PaulBichl/VibePCB-LA/boards/la-ecp5/hardware/la-ecp5-bottom.png

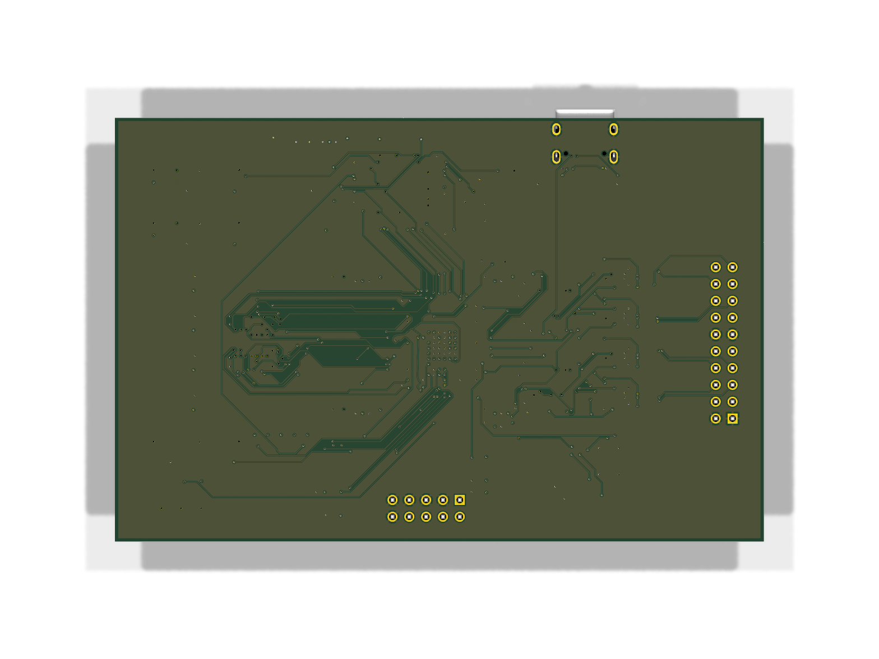
boards/la-ecp5/hardware/la-ecp5-bottom.png
