PaulBichl/VibePCB-LA/boards/la-ecp5/hardware/la-ecp5-bom.csv

Qty | Designator | Value | Footprint | MPN | LCSC Part #
24 | C1,C2,C3,C4,C6,C7,C8,C9,C10,C11,C13,C14,C15,C16,C17,C20,C21,C22,C23,C25,C32,C35,C36,C41 | 100nF | tscircuit:capacitor_cap0402 |  | C1525
6 | C5,C12,C40,C60,C70,C90 | 10uF | tscircuit:capacitor_cap0603 |  | C19702
2 | C18,C19 | 18pF | tscircuit:capacitor_cap0402 |  | C1549
1 | C24 | 4.7uF | tscircuit:capacitor_cap0603 |  | C19666
4 | C30,C31,C33,C34 | 1uF | tscircuit:capacitor_cap0402 |  | C52923
3 | C61,C71,C91 | 22uF | tscircuit:capacitor_cap0805 |  | C45783
4 | D1,D2,D3,D4 | SRV05-4 | tscircuit:SRV05-4 | SRV05-4 | C2836319
3 | D20,D21,D22 | KT-0603G | tscircuit:KT-0603G | KT-0603G | C12624
1 | J1 | pin_header_pinrow20_p2_54_nopinlabels_rows2 | tscircuit:pin_header_pinrow20_p2_54_nopinlabels_rows2
1 | J2 | TYPE-C-31-M-12 | tscircuit:TYPE-C-31-M-12 | TYPE-C-31-M-12 | C165948
1 | J5 | pin_header_pinrow10_p2_54_rows2 | tscircuit:pin_header_pinrow10_p2_54_rows2
3 | L1,L2,L3 | 2.2µH | tscircuit:inductor_0805 |  | C63167
2 | R1,R2 | 5.1kΩ | tscircuit:resistor_res0402 |  | C25905
2 | R3,R71 | 12kΩ | tscircuit:resistor_res0402 |  | C25752
13 | R4,R6,R7,R8,R9,R10,R50,R51,R54,R55,R72,R91,R93 | 10kΩ | tscircuit:resistor_res0402 |  | C25744
1 | R5 | 2.2kΩ | tscircuit:resistor_res0402 |  | C25879
2 | R52,R56 | 20kΩ | tscircuit:resistor_res0402 |  | C25765
2 | R53,R57 | 10Ω | tscircuit:resistor_res0402 |  | C25077
2 | R61,R92 | 22kΩ | tscircuit:resistor_res0402 |  | C25768
1 | R62 | 100kΩ | tscircuit:resistor_res0402 |  | C25741
3 | R80,R81,R82 | 330Ω | tscircuit:resistor_res0402 |  | C25104
4 | RN1,RN2,RN3,RN4 | 4D02WGJ0102TCE | tscircuit:4D02WGJ0102TCE | 4D02WGJ0102TCE | C25726
4 | RN5,RN6,RN7,RN8 | RTA02-4D105JTH | tscircuit:RTA02-4D105JTH | RTA02-4D105JTH | C458532
1 | U1 | LFE5U-25F-7BG256I | tscircuit:LFE5U-25F-7BG256I | LFE5U-25F-7BG256I | C1550762
1 | U2 | IS42S16160J-7BLI | tscircuit:IS42S16160J-7BLI | IS42S16160J-7BLI | C1348766
1 | U3 | FT2232HL-REEL | tscircuit:FT2232HL-REEL | FT2232HL-REEL | C27882
1 | U4 | USBLC6-2SC6 | tscircuit:USBLC6-2SC6 | USBLC6-2SC6 | C7519
1 | U5 | 93LC56BT-I/OT | tscircuit:93LC56BT-I_OT | 93LC56BT-I/OT | C190271
2 | U6,U7 | SN74LVC8T245PWR | tscircuit:SN74LVC8T245PWR | SN74LVC8T245PWR | C27643
1 | U8 | TLV9062IDR | tscircuit:TLV9062IDR | TLV9062IDR | C398355
1 | U9 | W25Q128JVSIQ | tscircuit:W25Q128JVSIQ | W25Q128JVSIQ | C97521
3 | U10,U11,U12 | TLV62569DBVR | tscircuit:TLV62569DBVR | TLV62569DBVR | C141836
1 | Y1 | X322512MSB4SI | tscircuit:X322512MSB4SI | X322512MSB4SI | C9002
1 | Y2 | SX3M100.000B20F30TNN | tscircuit:SX3M100_000B20F30TNN | SX3M100.000B20F30TNN | C5179979
