PaulBichl/VibePCB-LA/boards/la-ecp5/hardware/la-ecp5-schematic.pdf

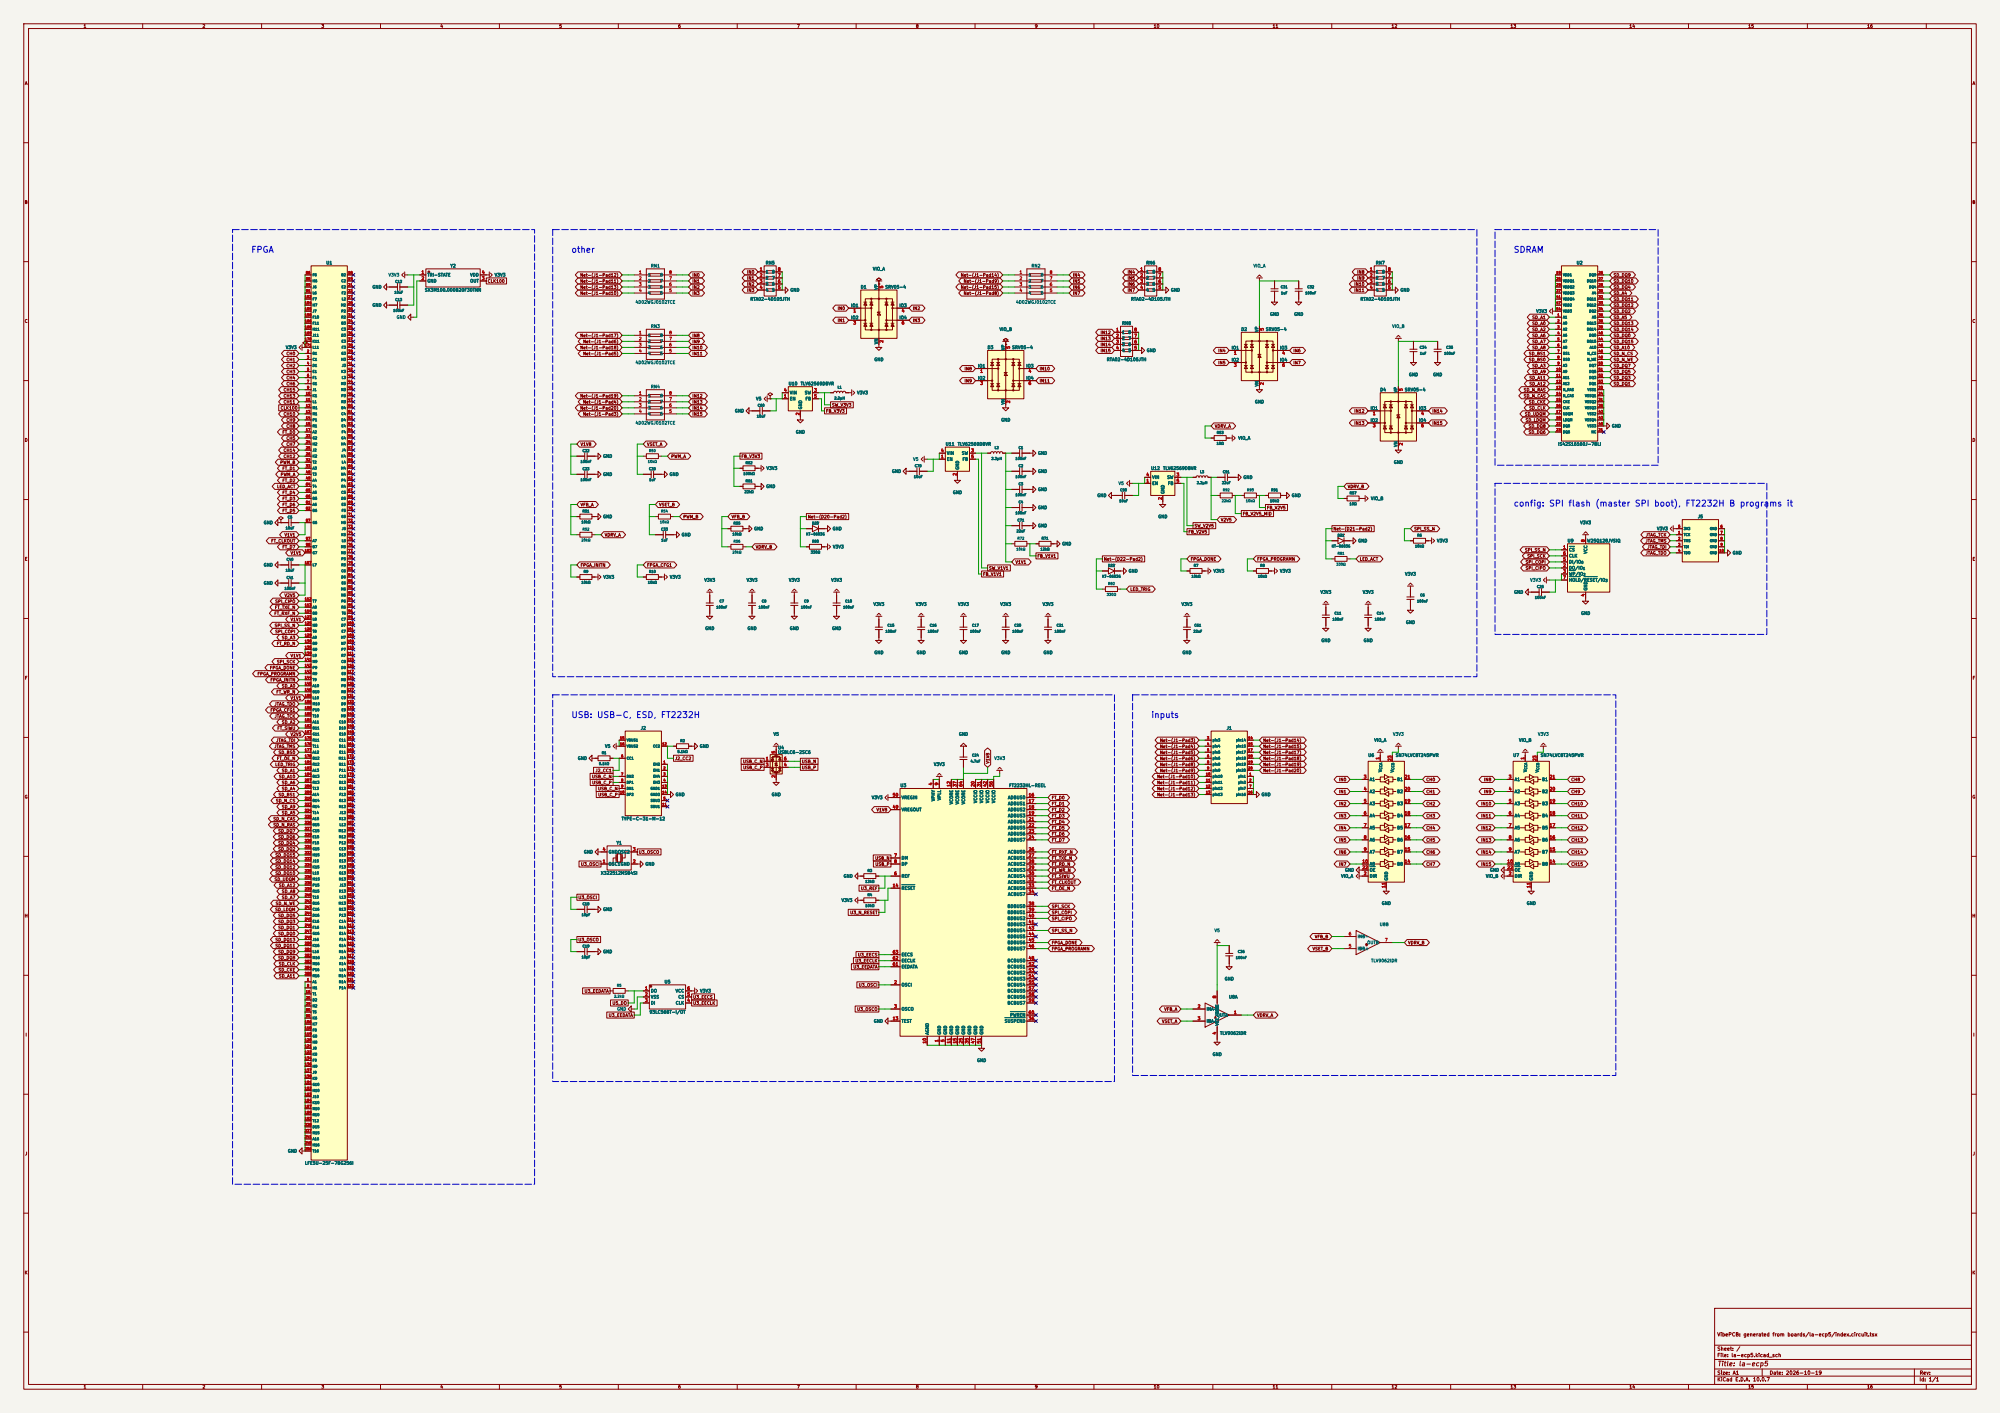
[picture p3: page 1]

config: SPI flash (master SPI boot), FT2232H B programs it

VibePCB: generated from boards/la-ecp5/index.circuit.tsx

Size: A1 | Rev:
KiCad E.D.A. 10.0.7 | Id: 1/1
