PaulBichl/VibePCB-LA/boards/la-ecp5/hardware/la-ecp5-layout.pdf

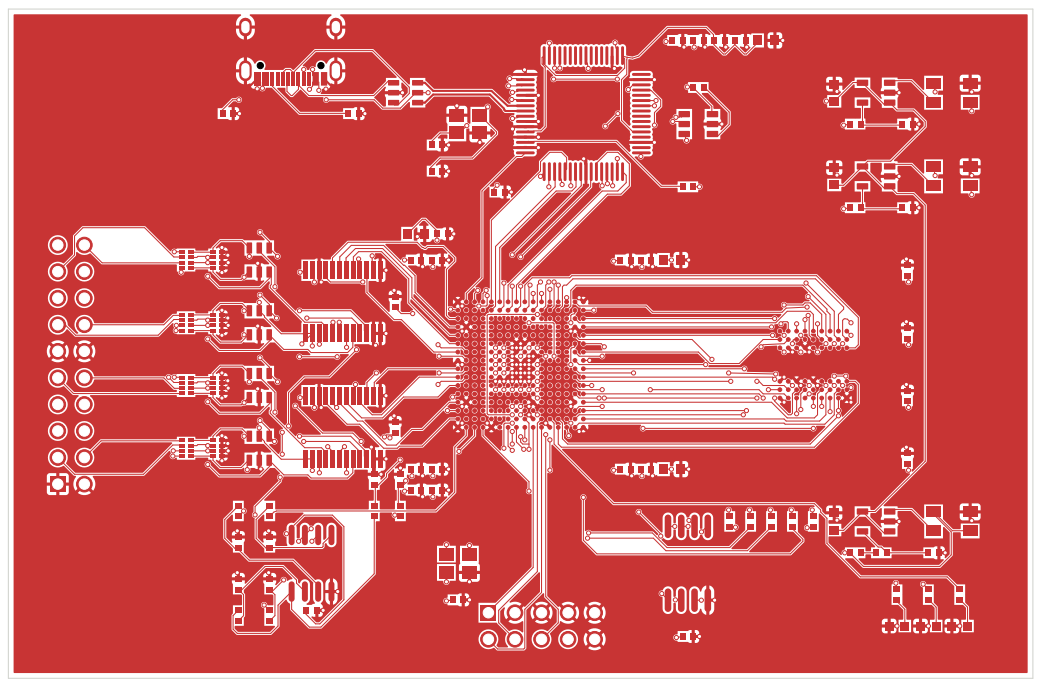
[picture p4: page 1]

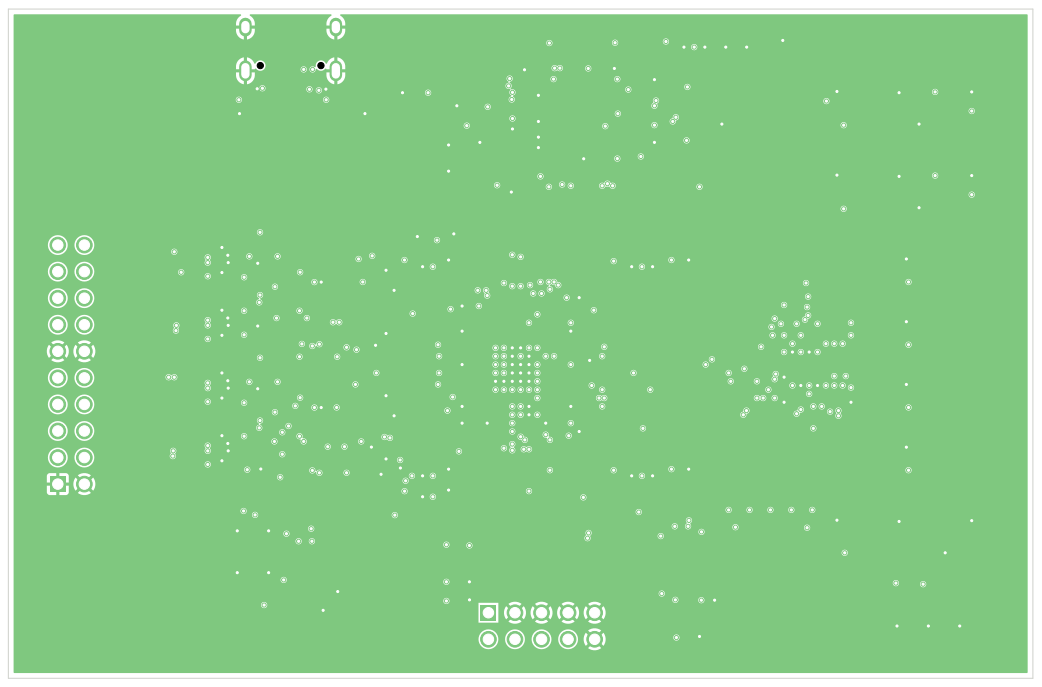
[picture p5: page 2]

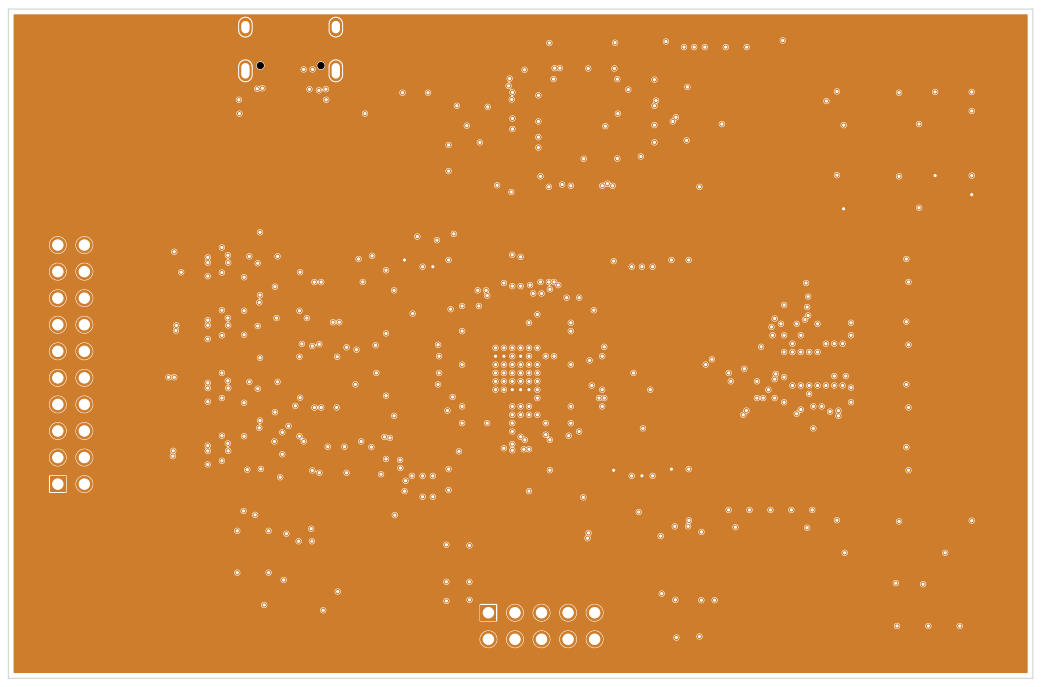
[picture p6: page 3]

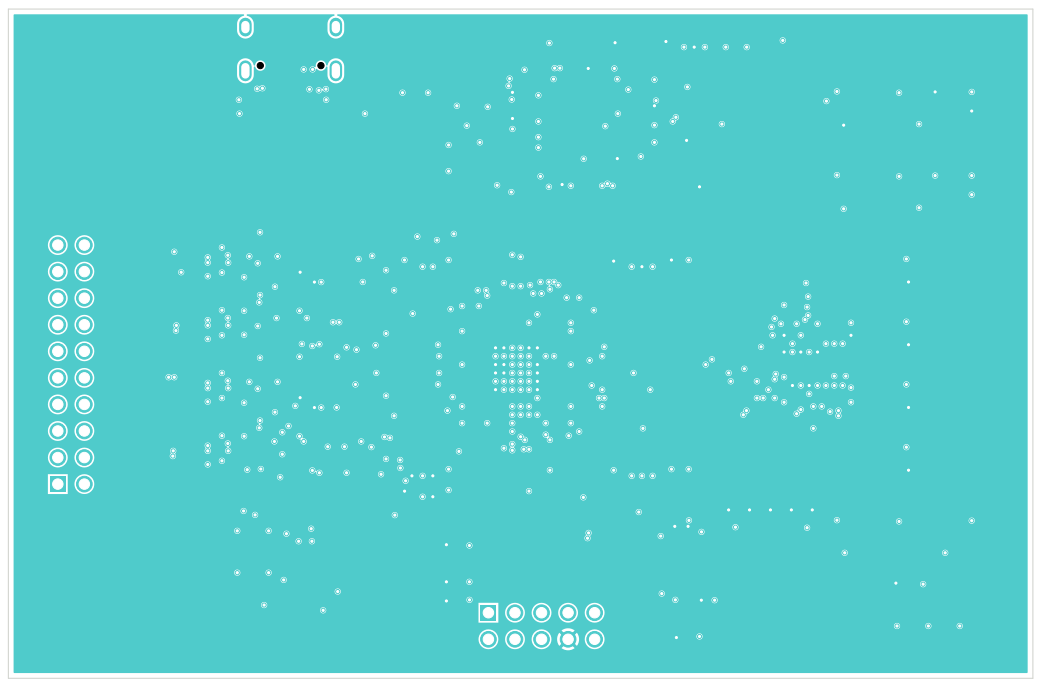
[picture p7: page 4]

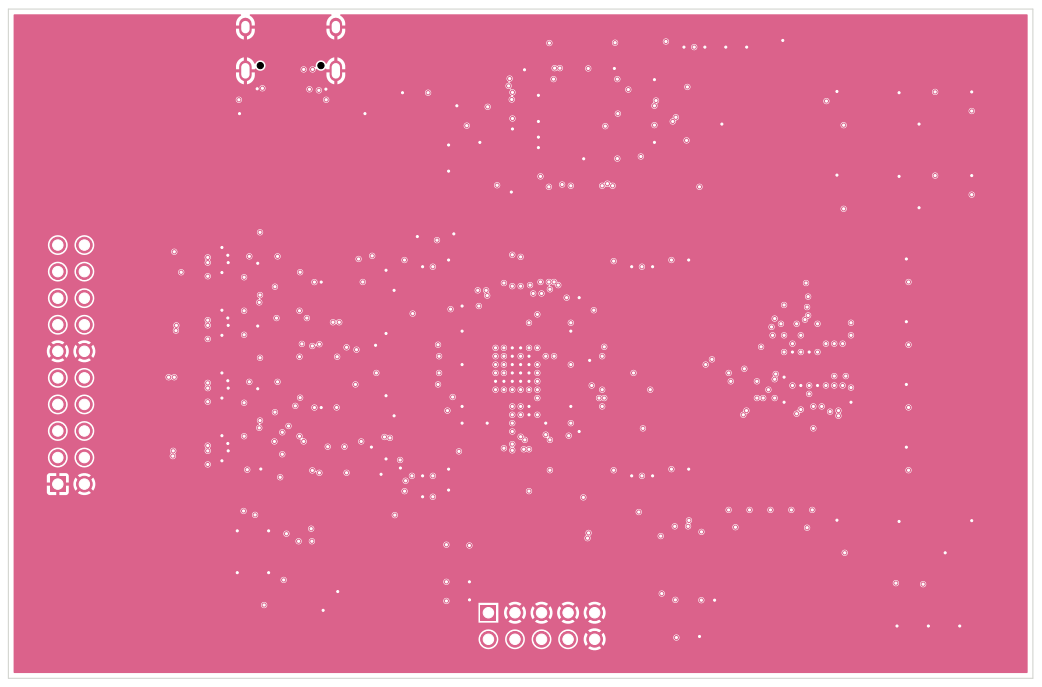
[picture p8: page 5]

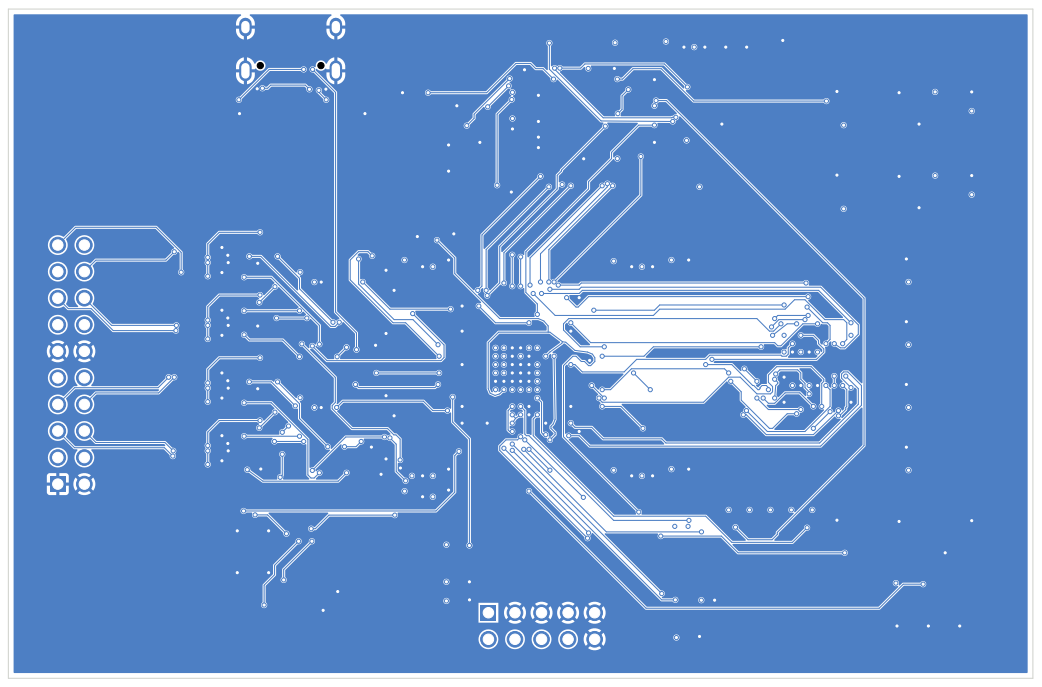
[picture p9: page 6]
