PaulBichl/VibePCB-LA/boards/la-ecp5/hardware/kicad/la-ecp5.kicad_pcb

## KiCad design boards/la-ecp5/hardware/kicad/la-ecp5.kicad_pcb (2026-10-22)

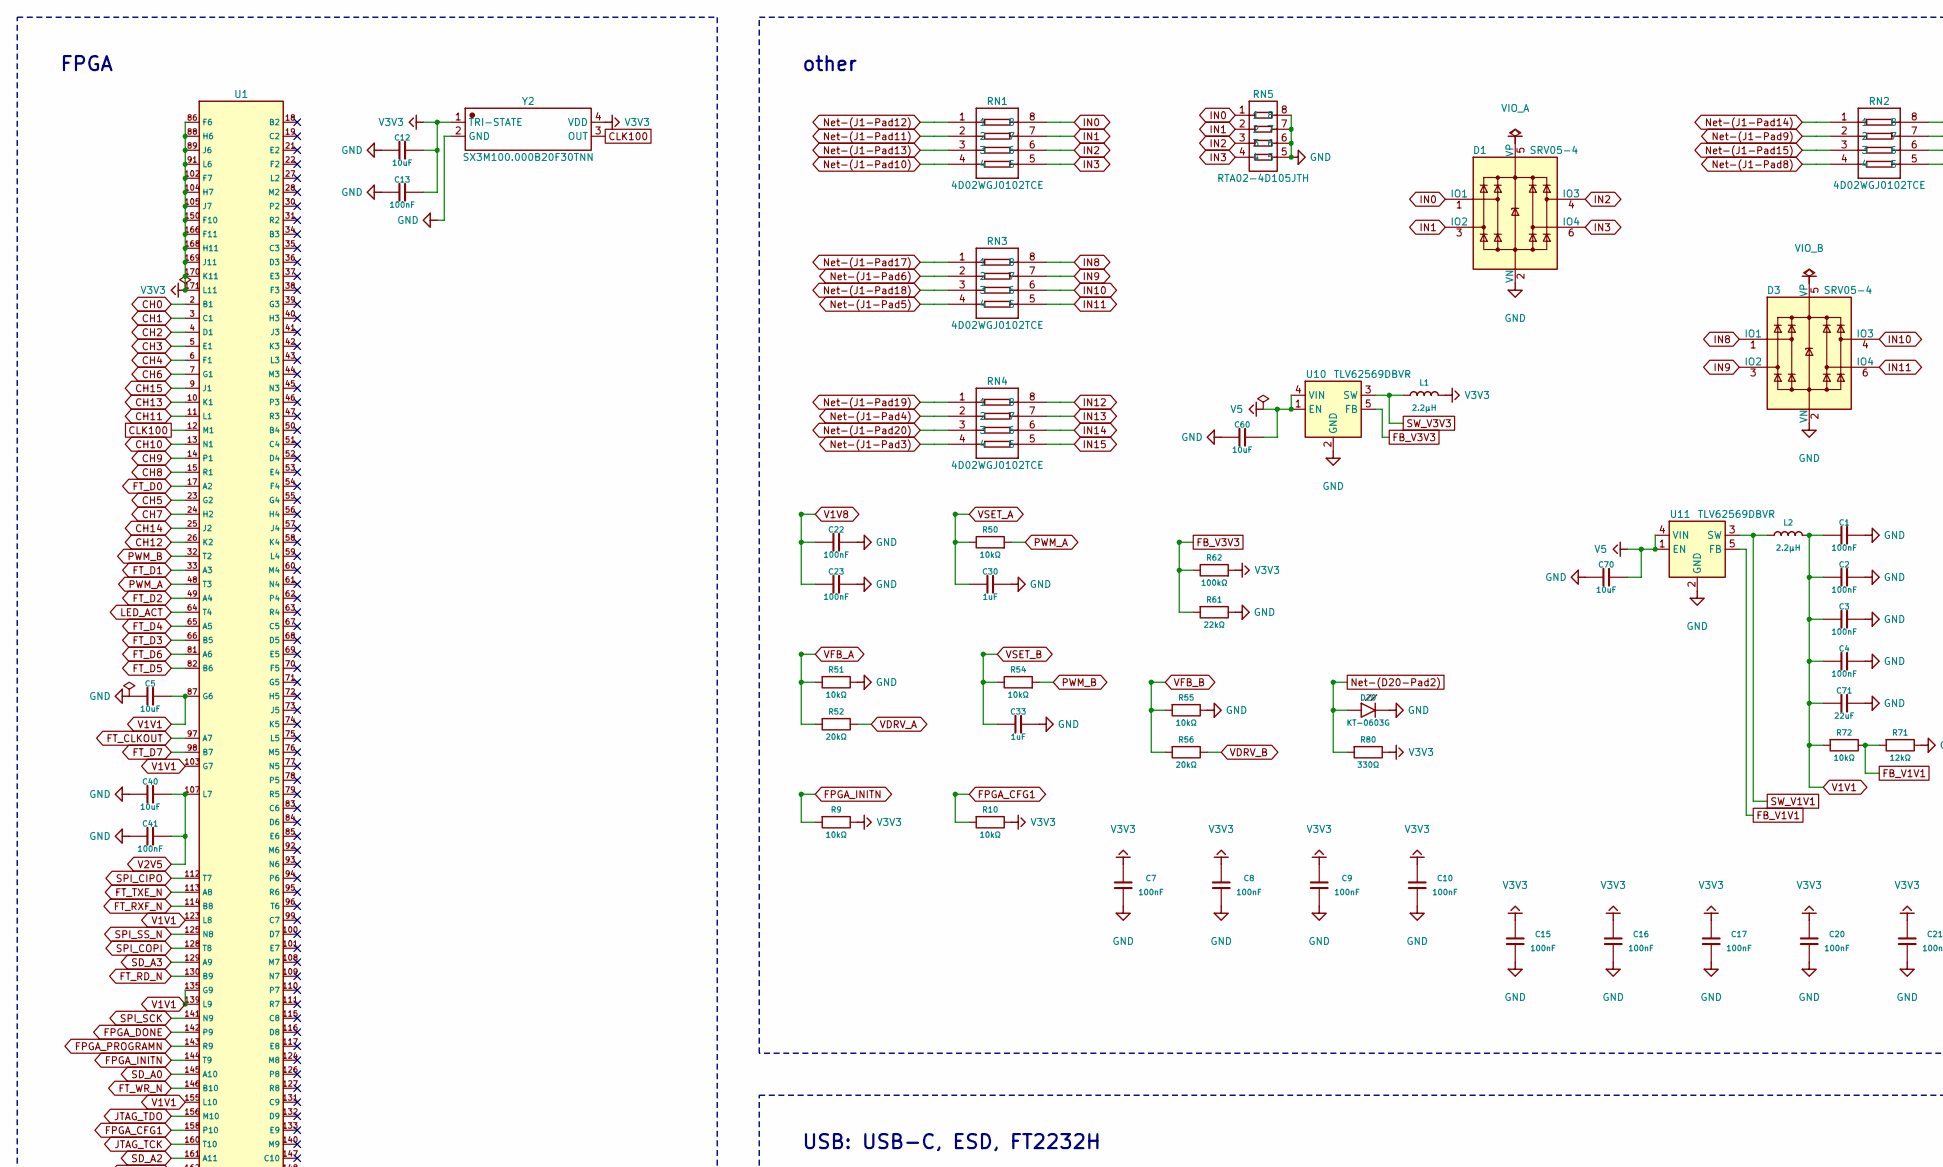
[picture p10: schematic la-ecp5.kicad_sch, part in row 1, column 1]

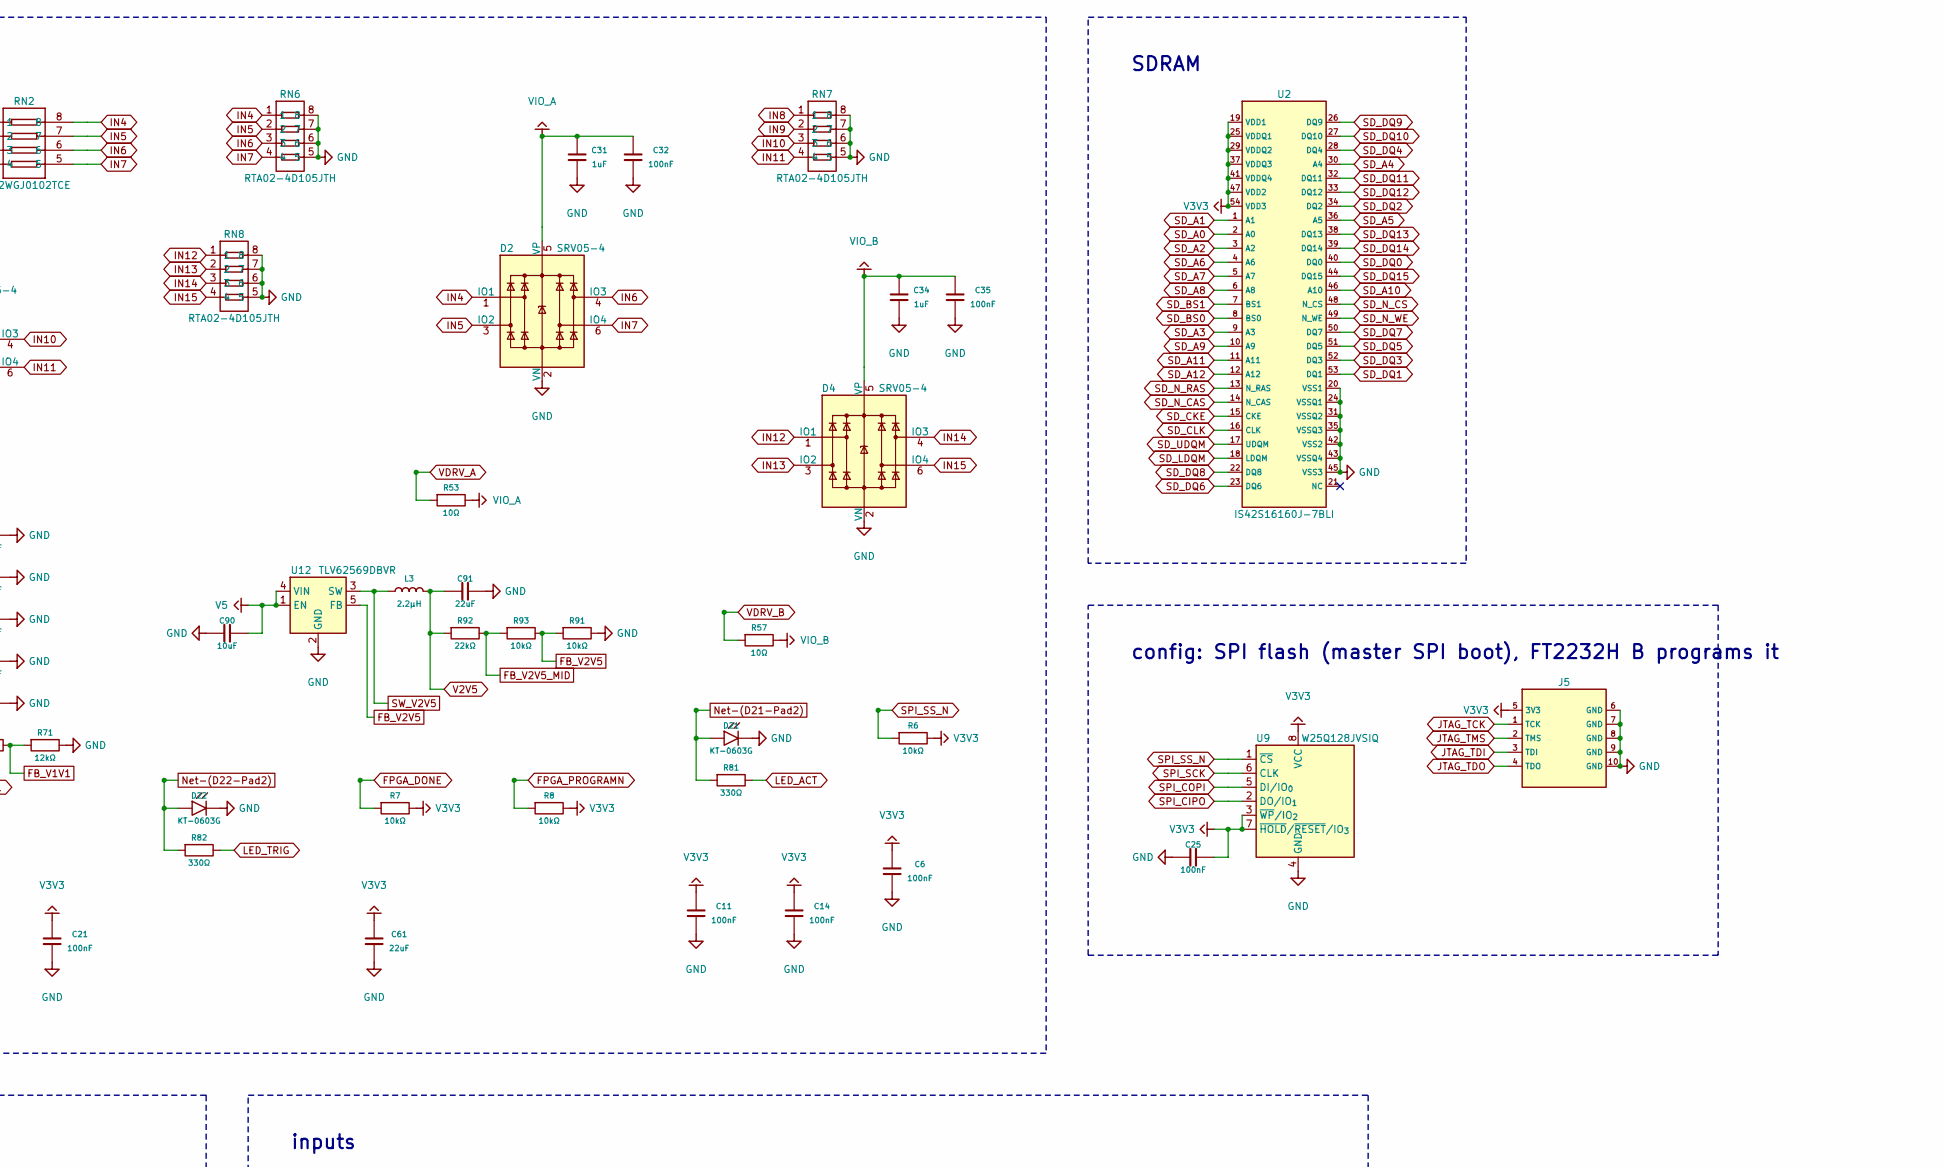
[picture p11: schematic la-ecp5.kicad_sch, part in row 1, column 2]

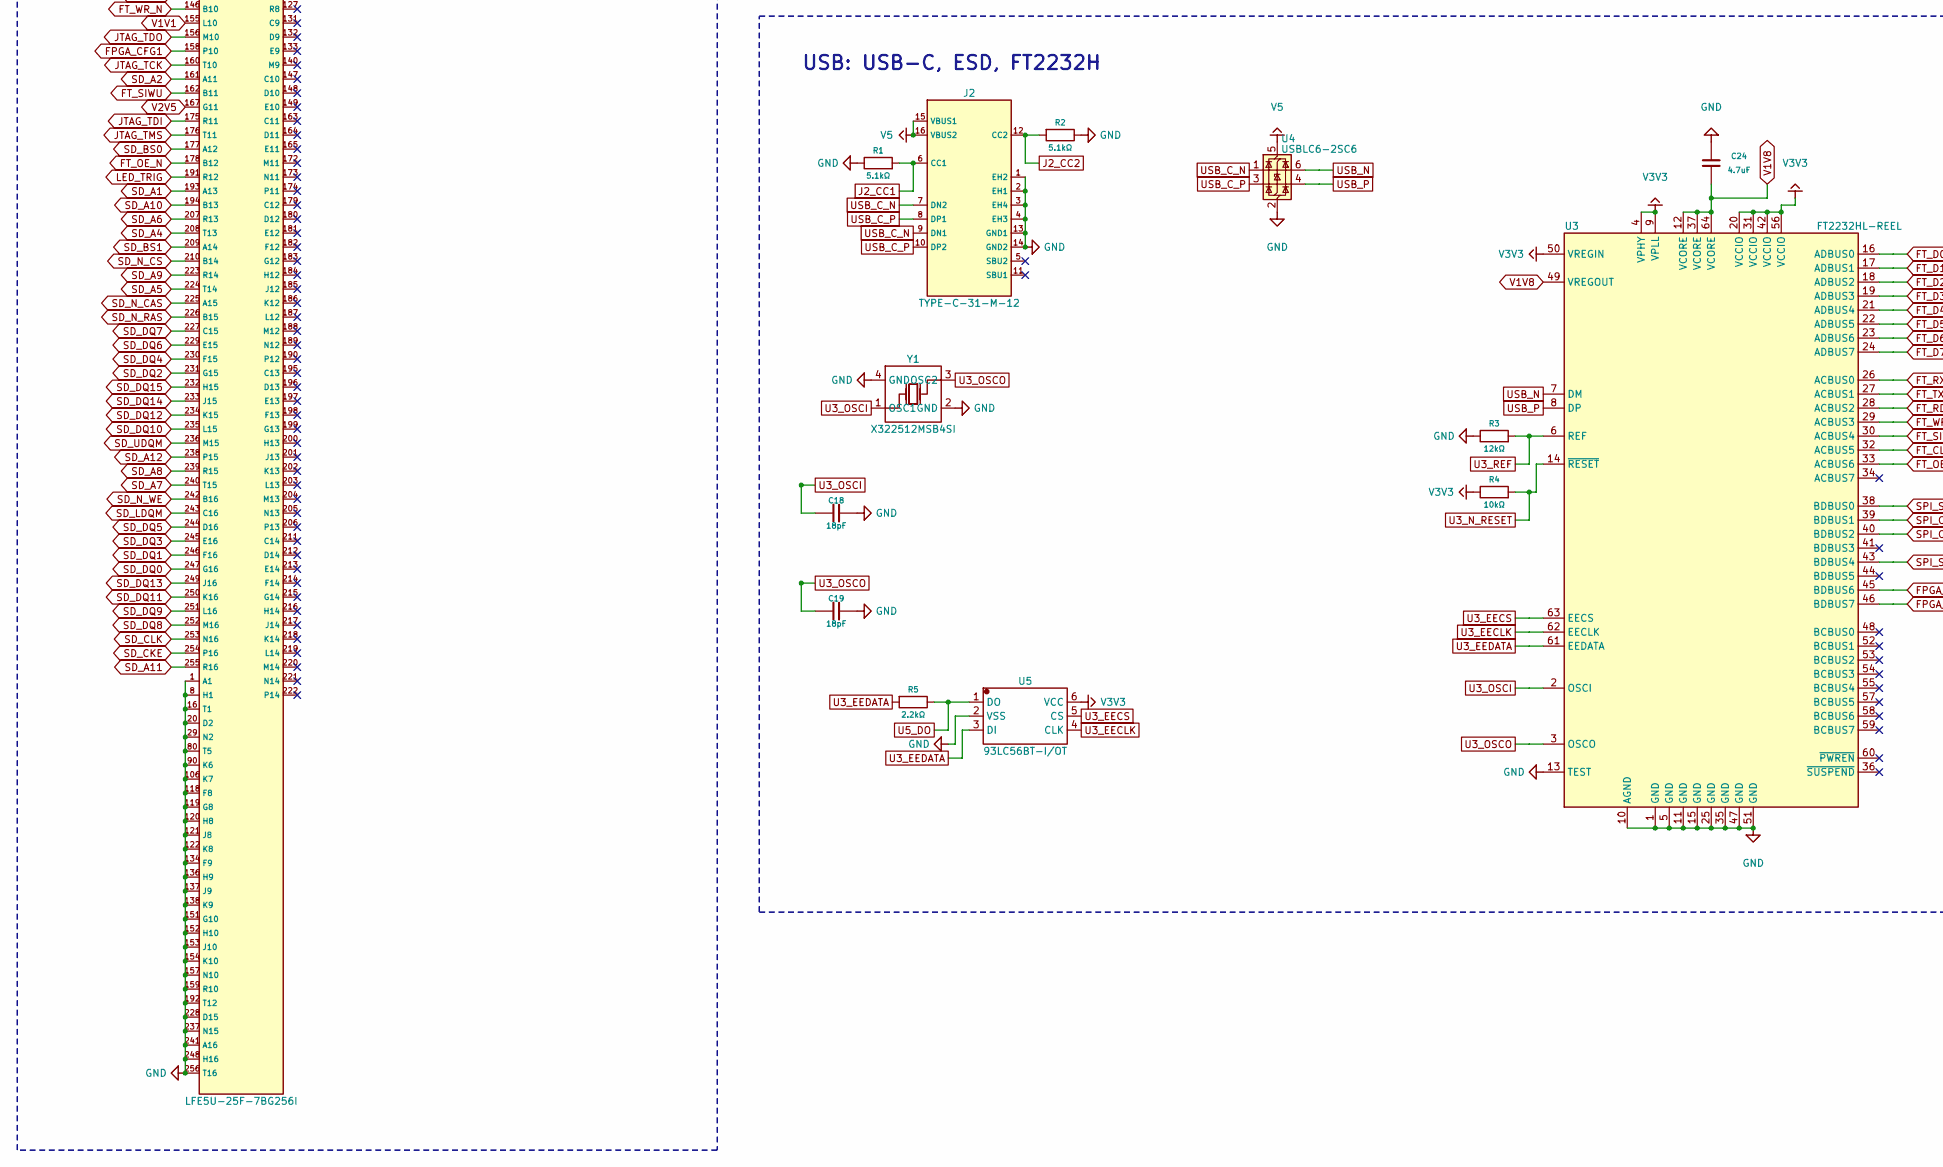
[picture p12: schematic la-ecp5.kicad_sch, part in row 2, column 1]

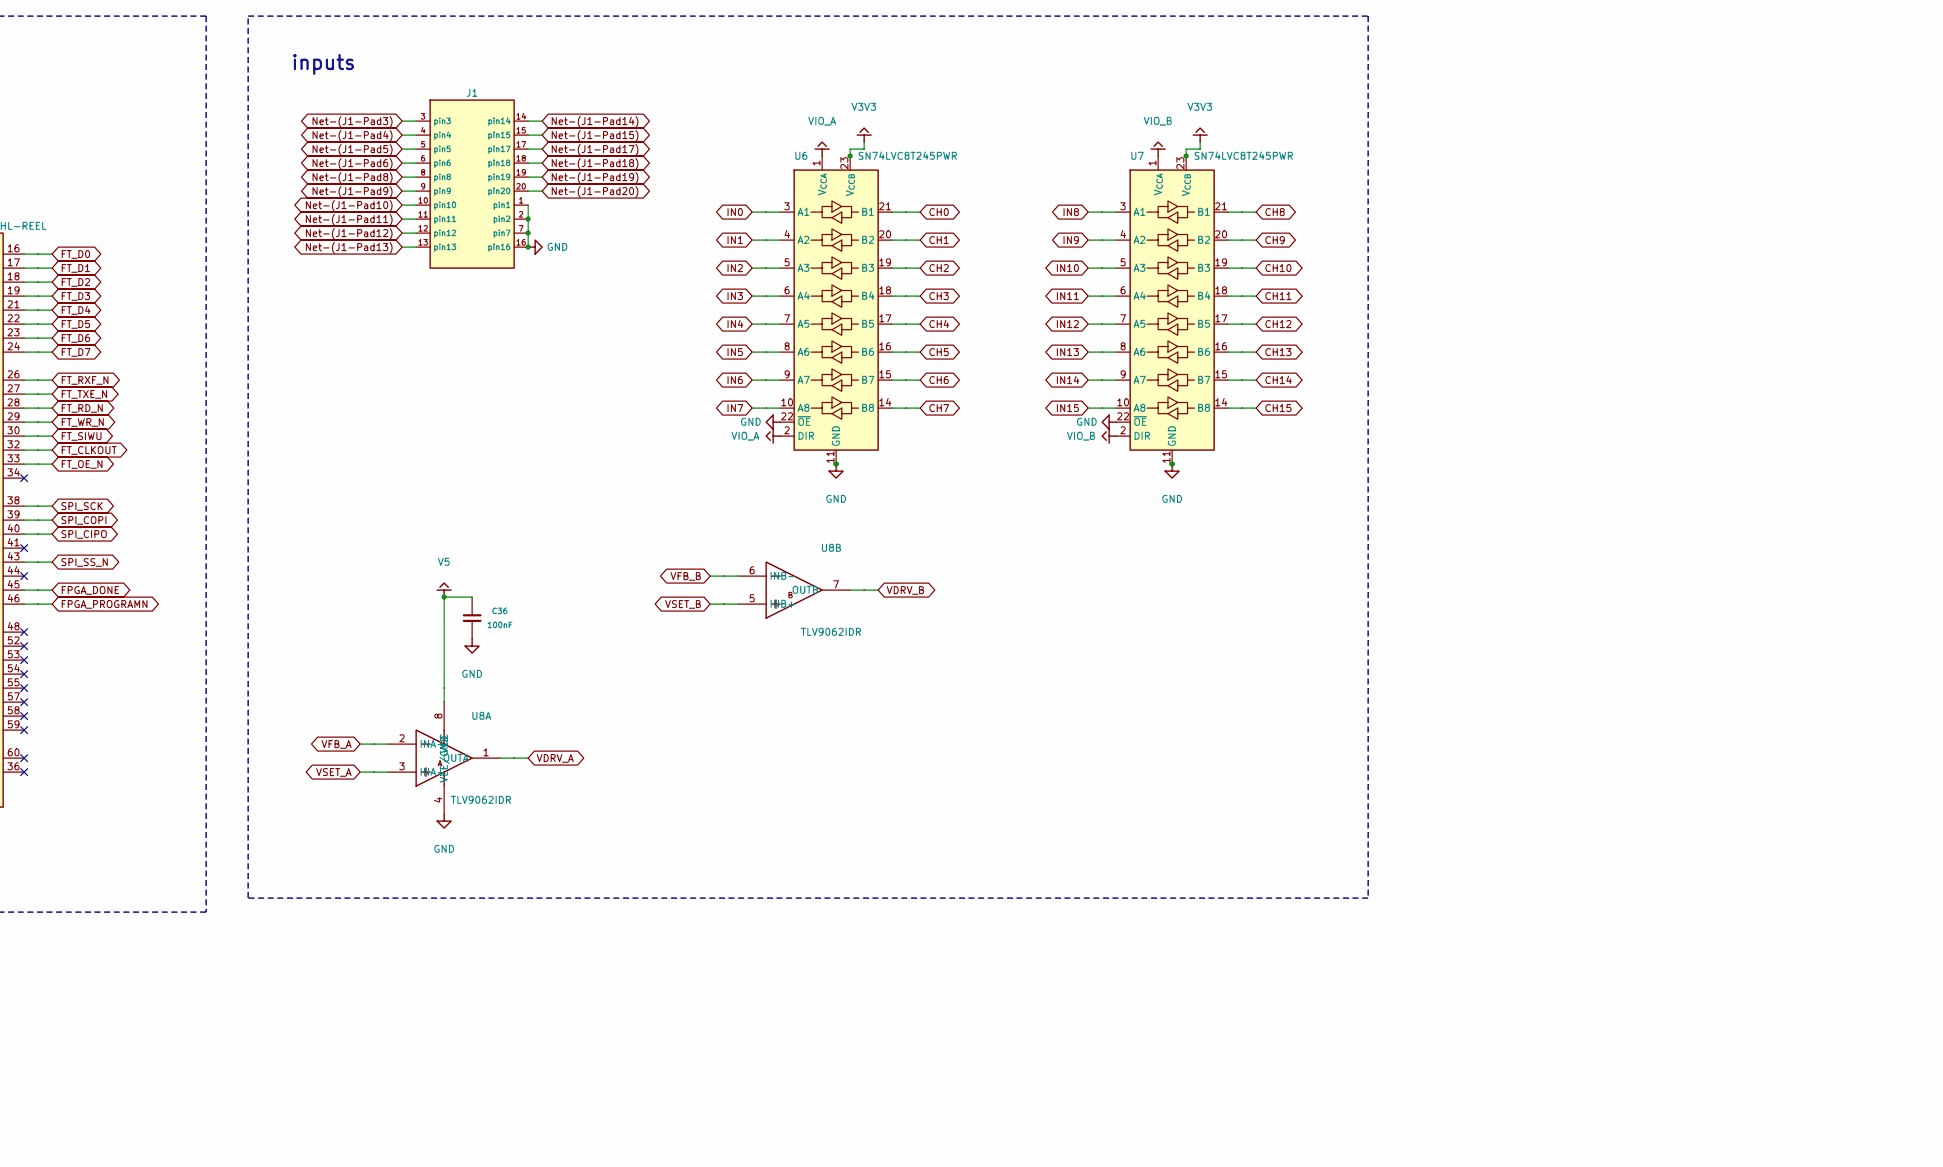
[picture p13: schematic la-ecp5.kicad_sch, part in row 2, column 2]

Parts:
C1, C2, C3, C4, C6, C7, C8, C9, C10, C11, C13, C14, C15, C16, C17, C20, C21, C22, C23, C25, C32, C35, C36, C41: 100nF; capacitor_cap0402; LCSC C1525
C5, C12, C40, C60, C70, C90: 10uF; capacitor_cap0603; LCSC C19702
C18, C19: 18pF; capacitor_cap0402; LCSC C1549
C24: 4.7uF; capacitor_cap0603; LCSC C19666
C30, C31, C33, C34: 1uF; capacitor_cap0402; LCSC C52923
C61, C71, C91: 22uF; capacitor_cap0805; LCSC C45783
D1, D2, D3, D4: SRV05-4; MPN SRV05-4; LCSC C2836319
D20, D21, D22: KT-0603G; MPN KT-0603G; LCSC C12624
J1: pin_header_pinrow20_p2_54_nopinlabels_rows2
J2: TYPE-C-31-M-12; MPN TYPE-C-31-M-12; LCSC C165948
J5: pin_header_pinrow10_p2_54_rows2
L1, L2, L3: 2.2µH; inductor_0805; LCSC C63167
R1, R2: 5.1kΩ; resistor_res0402; LCSC C25905
R3, R71: 12kΩ; resistor_res0402; LCSC C25752
R4, R6, R7, R8, R9, R10, R50, R51, R54, R55, R72, R91, R93: 10kΩ; resistor_res0402; LCSC C25744
R5: 2.2kΩ; resistor_res0402; LCSC C25879
R52, R56: 20kΩ; resistor_res0402; LCSC C25765
R53, R57: 10Ω; resistor_res0402; LCSC C25077
R61, R92: 22kΩ; resistor_res0402; LCSC C25768
R62: 100kΩ; resistor_res0402; LCSC C25741
R80, R81, R82: 330Ω; resistor_res0402; LCSC C25104
RN1, RN2, RN3, RN4: 4D02WGJ0102TCE; MPN 4D02WGJ0102TCE; LCSC C25726
RN5, RN6, RN7, RN8: RTA02-4D105JTH; MPN RTA02-4D105JTH; LCSC C458532
U1: LFE5U-25F-7BG256I; MPN LFE5U-25F-7BG256I; LCSC C1550762
U2: IS42S16160J-7BLI; MPN IS42S16160J-7BLI; LCSC C1348766
U3: FT2232HL-REEL; MPN FT2232HL-REEL; LCSC C27882
U4: USBLC6-2SC6; MPN USBLC6-2SC6; LCSC C7519
U5: 93LC56BT-I/OT; 93LC56BT-I_OT; MPN 93LC56BT-I/OT; LCSC C190271
U6, U7: SN74LVC8T245PWR; MPN SN74LVC8T245PWR; LCSC C27643
U8: TLV9062IDR; MPN TLV9062IDR; LCSC C398355
U9: W25Q128JVSIQ; MPN W25Q128JVSIQ; LCSC C97521
U10, U11, U12: TLV62569DBVR; MPN TLV62569DBVR; LCSC C141836
Y1: X322512MSB4SI; MPN X322512MSB4SI; LCSC C9002
Y2: SX3M100.000B20F30TNN; SX3M100_000B20F30TNN; MPN SX3M100.000B20F30TNN; LCSC C5179979

Connections:
CH0: U1.2 (B1), U6.21 (B1)
CH1: U1.3 (C1), U6.20 (B2)
CH2: U1.4 (D1), U6.19 (B3)
CH3: U1.5 (E1), U6.18 (B4)
CH4: U1.6 (F1), U6.17 (B5)
CH5: U1.23 (G2), U6.16 (B6)
CH6: U1.7 (G1), U6.15 (B7)
CH7: U1.24 (H2), U6.14 (B8)
CH8: U1.15 (R1), U7.21 (B1)
CH9: U1.14 (P1), U7.20 (B2)
CH10: U1.13 (N1), U7.19 (B3)
CH11: U1.11 (L1), U7.18 (B4)
CH12: U1.26 (K2), U7.17 (B5)
CH13: U1.10 (K1), U7.16 (B6)
CH14: U1.25 (J2), U7.15 (B7)
CH15: U1.9 (J1), U7.14 (B8)
CLK100: U1.12 (M1), Y2.3 (OUT)
FB_V1V1: R71.1, R72.2, U11.5 (FB)
FB_V2V5: R91.1, R93.2, U12.5 (FB)
FB_V2V5_MID: R92.2, R93.1
FB_V3V3: R61.1, R62.2, U10.5 (FB)
FPGA_CFG1: R10.1, U1.158 (P10)
FPGA_DONE: R7.1, U1.142 (P9), U3.45 (BDBUS6)
FPGA_INITN: R9.1, U1.144 (T9)
FPGA_PROGRAMN: R8.1, U1.143 (R9), U3.46 (BDBUS7)
FT_CLKOUT: U1.97 (A7), U3.32 (ACBUS5)
FT_D0: U1.17 (A2), U3.16 (ADBUS0)
FT_D1: U1.33 (A3), U3.17 (ADBUS1)
FT_D2: U1.49 (A4), U3.18 (ADBUS2)
FT_D3: U1.66 (B5), U3.19 (ADBUS3)
FT_D4: U1.65 (A5), U3.21 (ADBUS4)
FT_D5: U1.82 (B6), U3.22 (ADBUS5)
FT_D6: U1.81 (A6), U3.23 (ADBUS6)
FT_D7: U1.98 (B7), U3.24 (ADBUS7)
FT_OE_N: U1.178 (B12), U3.33 (ACBUS6)
FT_RD_N: U1.130 (B9), U3.28 (ACBUS2)
FT_RXF_N: U1.114 (B8), U3.26 (ACBUS0)
FT_SIWU: U1.162 (B11), U3.30 (ACBUS4)
FT_TXE_N: U1.113 (A8), U3.27 (ACBUS1)
FT_WR_N: U1.146 (B10), U3.29 (ACBUS3)
GND: C1.2, C2.2, C3.2, C4.2, C5.2, C6.2, C7.2, C8.2, C9.2, C10.2, C11.2, C12.2, C13.2, C14.2, C15.2, C16.2, C17.2, C18.2, C19.2, C20.2, C21.2, C22.2, C23.2, C24.2, C25.2, C30.2, C31.2, C32.2, C33.2, C34.2, C35.2, C36.2, C40.2, C41.2, C60.2, C61.2, C70.2, C71.2, C90.2, C91.2, D1.2 (VN), D2.2 (VN), D3.2 (VN), D4.2 (VN), D20.1 (cathode), D21.1 (cathode), D22.1 (cathode), J1.1, J1.2, J1.7, J1.16, J2.1 (EH2), J2.2 (EH1), J2.3 (EH4), J2.4 (EH3), J2.13 (GND1), J2.14 (GND2), J5.6 (GND), J5.7 (GND), J5.8 (GND), J5.9 (GND), J5.10 (GND), R1.2, R2.2, R3.2, R51.2, R55.2, R61.2, R71.2, R91.2, RN5.5, RN5.6, RN5.7, RN5.8, RN6.5, RN6.6, RN6.7, RN6.8, RN7.5, RN7.6, RN7.7, RN7.8, RN8.5, RN8.6, RN8.7, RN8.8, U1.1 (A1), U1.8 (H1), U1.16 (T1), U1.20 (D2), U1.29 (N2), U1.80 (T5), U1.90 (K6), U1.106 (K7), U1.118 (F8), U1.119 (G8), U1.120 (H8), U1.121 (J8), U1.122 (K8), U1.134 (F9), U1.136 (H9), U1.137 (J9), U1.138 (K9), U1.151 (G10), U1.152 (H10), U1.153 (J10), U1.154 (K10), U1.157 (N10), U1.159 (R10), U1.192 (T12), U1.228 (D15), U1.237 (N15), U1.241 (A16), U1.248 (H16), U1.256 (T16), U2.20 (VSS1), U2.24 (VSSQ1), U2.31 (VSSQ2), U2.35 (VSSQ3), U2.42 (VSS2), U2.43 (VSSQ4), U2.45 (VSS3), U3.1 (GND), U3.5 (GND), U3.10 (AGND), U3.11 (GND), U3.13 (TEST), U3.15 (GND), U3.25 (GND), U3.35 (GND), U3.47 (GND), U3.51 (GND), U4.2 (GND), U5.2 (VSS), U6.11 (GND), U6.12 (GND), U6.13 (GND), U6.22 (~OE), U7.11 (GND), U7.12 (GND), U7.13 (GND), U7.22 (~OE), U8.4 (VEE/GND), U9.4 (GND), U10.2 (GND), U11.2 (GND), U12.2 (GND), Y1.2 (GND), Y1.4 (GND), Y2.2 (GND)
IN0: D1.1 (IO1), RN1.8, RN5.1, U6.3 (A1)
IN1: D1.3 (IO2), RN1.7, RN5.2, U6.4 (A2)
IN2: D1.4 (IO3), RN1.6, RN5.3, U6.5 (A3)
IN3: D1.6 (IO4), RN1.5, RN5.4, U6.6 (A4)
IN4: D2.1 (IO1), RN2.8, RN6.1, U6.7 (A5)
IN5: D2.3 (IO2), RN2.7, RN6.2, U6.8 (A6)
IN6: D2.4 (IO3), RN2.6, RN6.3, U6.9 (A7)
IN7: D2.6 (IO4), RN2.5, RN6.4, U6.10 (A8)
IN8: D3.1 (IO1), RN3.8, RN7.1, U7.3 (A1)
IN9: D3.3 (IO2), RN3.7, RN7.2, U7.4 (A2)
IN10: D3.4 (IO3), RN3.6, RN7.3, U7.5 (A3)
IN11: D3.6 (IO4), RN3.5, RN7.4, U7.6 (A4)
IN12: D4.1 (IO1), RN4.8, RN8.1, U7.7 (A5)
IN13: D4.3 (IO2), RN4.7, RN8.2, U7.8 (A6)
IN14: D4.4 (IO3), RN4.6, RN8.3, U7.9 (A7)
IN15: D4.6 (IO4), RN4.5, RN8.4, U7.10 (A8)
J2_CC1: J2.6 (CC1), R1.1
J2_CC2: J2.12 (CC2), R2.1
JTAG_TCK: J5.1 (TCK), U1.160 (T10)
JTAG_TDI: J5.3 (TDI), U1.175 (R11)
JTAG_TDO: J5.4 (TDO), U1.156 (M10)
JTAG_TMS: J5.2 (TMS), U1.176 (T11)
LED_ACT: R81.2, U1.64 (T4)
LED_TRIG: R82.2, U1.191 (R12)
unnamed: D20.2 (anode), R80.1
unnamed: D21.2 (anode), R81.1
unnamed: D22.2 (anode), R82.1
unnamed: J1.3, RN4.4
unnamed: J1.4, RN4.2
unnamed: J1.5, RN3.4
unnamed: J1.6, RN3.2
unnamed: J1.8, RN2.4
unnamed: J1.9, RN2.2
unnamed: J1.10, RN1.4
unnamed: J1.11, RN1.2
unnamed: J1.12, RN1.1
unnamed: J1.13, RN1.3
unnamed: J1.14, RN2.1
unnamed: J1.15, RN2.3
unnamed: J1.17, RN3.1
unnamed: J1.18, RN3.3
unnamed: J1.19, RN4.1
unnamed: J1.20, RN4.3
PWM_A: R50.1, U1.48 (T3)
PWM_B: R54.1, U1.32 (T2)
SD_A0: U1.145 (A10), U2.2 (A0)
SD_A1: U1.193 (A13), U2.1 (A1)
SD_A2: U1.161 (A11), U2.3 (A2)
SD_A3: U1.129 (A9), U2.9 (A3)
SD_A4: U1.208 (T13), U2.30 (A4)
SD_A5: U1.224 (T14), U2.36 (A5)
SD_A6: U1.207 (R13), U2.4 (A6)
SD_A7: U1.240 (T15), U2.5 (A7)
SD_A8: U1.239 (R15), U2.6 (A8)
SD_A9: U1.223 (R14), U2.10 (A9)
SD_A10: U1.194 (B13), U2.46 (A10)
SD_A11: U1.255 (R16), U2.11 (A11)
SD_A12: U1.238 (P15), U2.12 (A12)
SD_BS0: U1.177 (A12), U2.8 (BS0)
SD_BS1: U1.209 (A14), U2.7 (BS1)
SD_CKE: U1.254 (P16), U2.15 (CKE)
SD_CLK: U1.253 (N16), U2.16 (CLK)
SD_DQ0: U1.247 (G16), U2.40 (DQ0)
SD_DQ1: U1.246 (F16), U2.53 (DQ1)
SD_DQ2: U1.231 (G15), U2.34 (DQ2)
SD_DQ3: U1.245 (E16), U2.52 (DQ3)
SD_DQ4: U1.230 (F15), U2.28 (DQ4)
SD_DQ5: U1.244 (D16), U2.51 (DQ5)
SD_DQ6: U1.229 (E15), U2.23 (DQ6)
SD_DQ7: U1.227 (C15), U2.50 (DQ7)
SD_DQ8: U1.252 (M16), U2.22 (DQ8)
SD_DQ9: U1.251 (L16), U2.26 (DQ9)
SD_DQ10: U1.235 (L15), U2.27 (DQ10)
SD_DQ11: U1.250 (K16), U2.32 (DQ11)
SD_DQ12: U1.234 (K15), U2.33 (DQ12)
SD_DQ13: U1.249 (J16), U2.38 (DQ13)
SD_DQ14: U1.233 (J15), U2.39 (DQ14)
SD_DQ15: U1.232 (H15), U2.44 (DQ15)
SD_LDQM: U1.243 (C16), U2.18 (LDQM)
SD_N_CAS: U1.225 (A15), U2.14 (N_CAS)
SD_N_CS: U1.210 (B14), U2.48 (N_CS)
SD_N_RAS: U1.226 (B15), U2.13 (N_RAS)
SD_N_WE: U1.242 (B16), U2.49 (N_WE)
SD_UDQM: U1.236 (M15), U2.17 (UDQM)
SW_V1V1: L2.1, U11.3 (SW)
SW_V2V5: L3.1, U12.3 (SW)
SW_V3V3: L1.1, U10.3 (SW)
U3_EECLK: U3.62 (EECLK), U5.4 (CLK)
U3_EECS: U3.63 (EECS), U5.5 (CS)
U3_EEDATA: R5.1, U3.61 (EEDATA), U5.3 (DI)
U3_N_RESET: R4.1, U3.14 (~RESET)
U3_OSCI: C18.1, U3.2 (OSCI), Y1.1 (OSC1)
U3_OSCO: C19.1, U3.3 (OSCO), Y1.3 (OSC2)
U3_REF: R3.1, U3.6 (REF)
U5_DO: R5.2, U5.1 (DO)
USB_C_N: J2.7 (DN2), J2.9 (DN1), U4.1 (I/O1)
USB_C_P: J2.8 (DP1), J2.10 (DP2), U4.3 (I/O2)
USB_N: U3.7 (DM), U4.6 (I/O1)
USB_P: U3.8 (DP), U4.4 (I/O2)
V1V1: C1.1, C2.1, C3.1, C4.1, C5.1, C71.1, L2.2, R72.1, U1.87 (G6), U1.103 (G7), U1.123 (L8), U1.135 (G9), U1.139 (L9), U1.155 (L10)
V1V8: C22.1, C23.1, C24.1, U3.12 (VCORE), U3.37 (VCORE), U3.49 (VREGOUT), U3.64 (VCORE)
V2V5: C40.1, C41.1, C91.1, L3.2, R92.1, U1.107 (L7), U1.167 (G11)
V3V3: C6.1, C7.1, C8.1, C9.1, C10.1, C11.1, C12.1, C13.1, C14.1, C15.1, C16.1, C17.1, C20.1, C21.1, C25.1, C61.1, J5.5 (3V3), L1.2, R4.2, R6.2, R7.2, R8.2, R9.2, R10.2, R62.1, R80.2, U1.86 (F6), U1.88 (H6), U1.89 (J6), U1.91 (L6), U1.102 (F7), U1.104 (H7), U1.105 (J7), U1.150 (F10), U1.166 (F11), U1.168 (H11), U1.169 (J11), U1.170 (K11), U1.171 (L11), U2.19 (VDD1), U2.25 (VDDQ1), U2.29 (VDDQ2), U2.37 (VDDQ3), U2.41 (VDDQ4), U2.47 (VDD2), U2.54 (VDD3), U3.4 (VPHY), U3.9 (VPLL), U3.20 (VCCIO), U3.31 (VCCIO), U3.42 (VCCIO), U3.50 (VREGIN), U3.56 (VCCIO), U5.6 (VCC), U6.23 (V_{CCB}), U6.24 (V_{CCB}), U7.23 (V_{CCB}), U7.24 (V_{CCB}), U9.3 (~WP/IO_{2}), U9.7 (~HOLD/~RESET/IO_{3}), U9.8 (VCC), Y2.1 (TRI-STATE), Y2.4 (VDD)
V5: C36.1, C60.1, C70.1, C90.1, J2.15 (VBUS1), J2.16 (VBUS2), U4.5 (VBUS), U8.8 (VCC), U10.1 (EN), U10.4 (VIN), U11.1 (EN), U11.4 (VIN), U12.1 (EN), U12.4 (VIN)
VDRV_A: R52.2, R53.1, U8.1 (OUTA)
VDRV_B: R56.2, R57.1, U8.7 (OUTB)
VFB_A: R51.1, R52.1, U8.2 (INA-)
VFB_B: R55.1, R56.1, U8.6 (INB-)
VIO_A: C31.1, C32.1, D1.5 (VP), D2.5 (VP), R53.2, U6.1 (V_{CCA}), U6.2 (DIR)
VIO_B: C34.1, C35.1, D3.5 (VP), D4.5 (VP), R57.2, U7.1 (V_{CCA}), U7.2 (DIR)
VSET_A: C30.1, R50.2, U8.3 (INA+)
VSET_B: C33.1, R54.2, U8.5 (INB+)

Notes on the sheet:
FPGA
other
SDRAM
USB: USB-C, ESD, FT2232H
config: SPI flash (master SPI boot), FT2232H B programs it
inputs

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
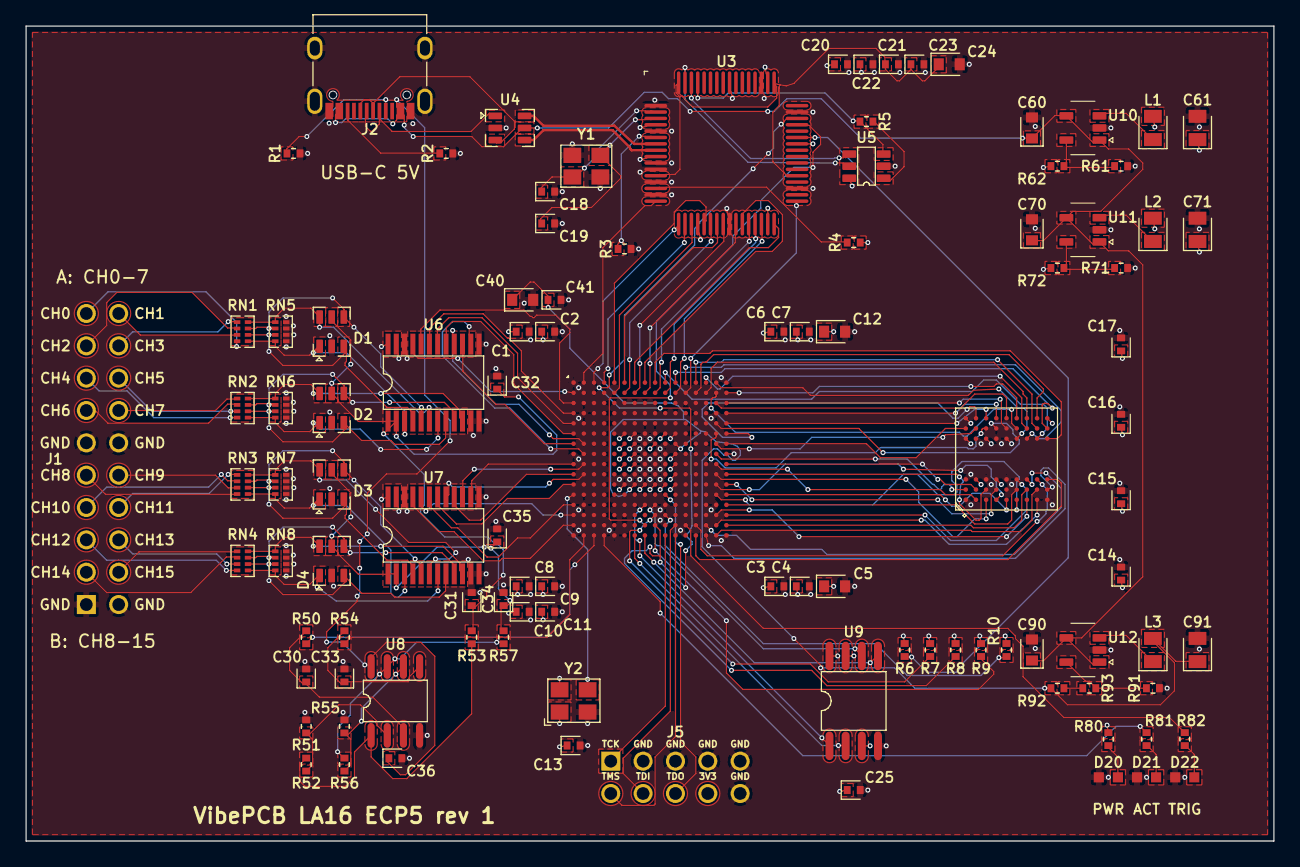
[picture p14: board la-ecp5.kicad_pcb from above]

Board: 6 copper layers, 98.0 x 64.0 mm, 103 parts (0 on the bottom side), 158 nets.
