PaulBichl/VibePCB-LA/(commit log)

2026-10-14 Logic analyzer: repo skeleton (latest tscircuit), ECP5 pin map from Lattice's pinout, BGA + SDRAM spike (WIP)
    [ecp5u25-pinout.csv]
2026-10-15 la-main: full board on iCE40HX4K TQFP-144, 4 layers - routes, 2 DRC issues left (power-track knots); geometric SDRAM pin pairing, arrays for the input chain, budget-based length groups
2026-10-15 la-main passes check: GND pads to the plane through own vias ([planes]); budget-based length groups
2026-10-15 Remove the spike / variant boards (lessons in CLAUDE.md and VibePCB docs/TODO.md, history keeps them); README and CLAUDE.md describe la-main
    [ecp5u25-pinout.csv]
2026-10-15 gitignore from VibePCB template; USB-C label moved; planes = GND only
2026-10-15 README: how the board works, block diagram, why the iCE40
2026-10-18 la-bga54m: la-bga54e routed by VibePCB's router ([routing] mode = manual, routes.toml: SDRAM bus in planar order, USB, the rest shortest first; V3V3 plane on In2) - check passes
2026-10-18 la-ecp5m: ECP5 CABGA-256 escape board routed by VibePCB's router (one bus per header in planar order, inner layers poured from the config) - check passes
2026-10-19 la-ecp5: coupled USB pair ([[pair]], 7.3 mm coupled, skew +0.09 mm); USBLC6 rotated to face the FT2232H and its channels swapped (D+ on IO2) so P / N keep their order - check passes
    Claude-Session: https://claude.ai/code/session_01U6wHqsa9TpywG2yXs1w1iL
2026-10-22 Showcase: la-ecp5 is the one board; README and CLAUDE.md rewritten for it, hardware/ published
    - Remove the superseded boards (iCE40 la-main, la-bga54m, la-ecp5m); history keeps them
    - boards/la-ecp5/hardware/ (pcb publish): schematic PDF, layout PDF + SVGs, 3D renders, BOM,
    KiCad project - all linked from the README
    - README: ECP5 / BGA SDRAM design, spec, block diagram, layout notes, parts, build
    - package.json: tscircuit 0.0.2900, the version la-ecp5 was built with
    [la-ecp5-bom.csv, la-ecp5.kicad_pcb, la-ecp5.kicad_sch]
